chipiki/gnu_friata/README

FRIATA - Free/Open Telephone ATA Hardware
=========================================
Egg & Sausage Filled Tart and Hashbrowns

mailto:kalyanamsaritha_at_gmail_dot_com['Saritha Kalyanam']

+ 10/100 Mbps Ethernet interface
+ Single Port FXS - Analog telephone interface
+ USB Host (full speed) - Wifi USB dongle for wifi interface
+ USB Device (full speed) - USB phone device (a la Skype)

Directories
===========
sym/    Schematic symbol library. Borrowed heavily from
        http://www.gedasymbols.org

pkg/    Footprint library. Borrowed heavily from http://www.gedasymbols.org
