chipiki/gnu_friata/friata-bom.ods

Device | Value | Footprint | Manufacturer | Manufacturer Part | Vendor | Vendor Part | Quantity | Refdes
AT45DB161D | unknown | TSOP-28 |  |  |  |  | 1 | U15
AT91SAM9260 | unknown | PQFP-208 |  |  |  |  | 1 | U1
CAPACITOR | 100nF/25V | 603 |  |  |  |  | 57 | C1 C10 C101 C102 C11 C12 C16 C17 C18 C19 C2 C20 C21 C22 C23 C25 C3 C35 C36 C37 C38 C39 C4 C41 C42 C43 C44 C45 C46 C5 C52 C53 C54 C58 C6 C66 C67 C68 C69 C7 C70 C71 C72 C75 C78 C8 C88 C89 C9 C90 C91 C92 C93 C94 C95 C96 C97
CAPACITOR | 100nF/50V | 1206 |  |  |  |  | 1 | C55
CAPACITOR | 100uF/35V | PANASONIC_V_FC_10x10 |  |  |  |  | 3 | C74 C86 C87
CAPACITOR | 10nF/16V | 603 |  |  |  |  | 1 | C27
CAPACITOR | 10nF/50V | 805 |  |  |  |  | 1 | C100
CAPACITOR | 10uF/100V | PANASONIC_V_HA_8x10 |  |  |  |  | 1 | C56
CAPACITOR | 10uF/35V | PANASONIC_V_FC_5x5 |  |  |  |  | 1 | C65
CAPACITOR | 10uF/6.3V | 805 |  |  |  |  | 12 | C103 C104 C13 C14 C15 C24 C26 C40 C61 C62 C63 C64
CAPACITOR | 18pF | 603 |  |  |  |  | 6 | C29 C30 C31 C32 C33 C34
CAPACITOR | 1nF/25V | 603 |  |  |  |  | 4 | C28 C77 C98 C99
CAPACITOR | 1uF/25V | 805 |  |  |  |  | 4 | C80 C81 C83 C84
CAPACITOR | 220nF/100V | 805 |  |  |  |  | 2 | C50 C51
CAPACITOR | 22nF/100V | 805 |  |  |  |  | 2 | C59 C60
CAPACITOR | 4.7nF/25V | 805 |  |  |  |  | 2 | C76 C79
CAPACITOR | 4.7uF/16V | 805 |  |  |  |  | 2 | C47 C48
CAPACITOR | 4.7uF/25V | 805 |  |  |  |  | 1 | C73
CAPACITOR | 68uF/10V | 2512 |  |  |  |  | 2 | C82 C85
CONNECTOR-DB9-FEMALE | 190-009-263R001 | CONN-DB9-FEMALE-SMT |  |  |  |  | 1 | CONN4
CONNECTOR-DCJACK | RASM722P | CONN-RASM722-SMT |  |  |  |  | 1 | CONN3
CONNECTOR-RJ11 | MOLEX-44144-0005 | CONN-RJ11-6P6C-SMT |  |  |  |  | 1 | CONN7
CONNECTOR-RJ45 | J3026G01DNL | CONN-RJ45-J3026G01DNL |  |  |  |  | 1 | CONN1
CONNECTOR-USB-A-FEMALE | KUSBX-SMT-AS1N-xxx | CONN-USB-A-FEMALE-SMT |  |  |  |  | 1 | CONN5
CONNECTOR-USB-B-FEMALE | KUSBX-SMT-BS1N-xxx | CONN-USB-B-FEMALE-SMT |  |  |  |  | 1 | CONN6
CRYSTAL | 18.432 MHz | XTAL-CITIZEN-HCM49 |  |  |  |  | 1 | X1
CRYSTAL | 25MHz | XTAL-CITIZEN-HCM49 |  |  |  |  | 1 | X3
CRYSTAL | 32.768 kHz | XTAL-ECS-ECX39 |  |  |  |  | 1 | X2
DIODE | ES1D | DO-214 |  |  |  |  | 1 | D1
DIODE-BRIDGE | DF10s | SDIP-4L |  |  |  |  | 1 | U20
DM83848I | unknown | PQFP-48 |  |  |  |  | 1 | U13
FUSE | 500mA | 2920 |  |  |  |  | 2 | F1 F2
HEADER | unknown | HEADER-0.1in_20pin_2row-THRU |  |  |  |  | 1 | J4
HEADER | unknown | HEADER-0.1in_2pin_1row-THRU |  |  |  |  | 6 | J1 J10 J2 J3 J5 J7
HEADER | unknown | HEADER-0.1in_3pin_1row-THRU |  |  |  |  | 2 | J8 J9
HOLE | unknown | HOLE_M3 |  |  |  |  | 4 | H1 H2 H3 H4
INDUCTOR | 100uH/1.5A | MURATA_4500 |  |  |  |  | 1 | L5
INDUCTOR | 100uH/1.5A | MURATA_4600 |  |  |  |  | 1 | L8
INDUCTOR | 22uH/1.5A | MURATA_4600 |  |  |  |  | 2 | L6 L7
INDUCTOR | 4.7uH/150mA | 603 |  |  |  |  | 2 | L1 L9
INDUCTOR | 47uH/150mA | 603 |  |  |  |  | 1 | L2
INDUCTOR | BLM18AG601SN1 | 603 |  |  |  |  | 2 | L3 L4
LED | unknown | 1206 |  |  |  |  | 3 | D2 D6 D7
LM2675 | unknown | SO-8 |  |  |  |  | 1 | U25
LM2717 | unknown | TSSOP-24 |  |  |  |  | 1 | U19
MT29F2G08AACWP-ET | unknown | TSOP-48 |  |  |  |  | 1 | U14
MT48LC8M16A2P-75-L | unknown | TSOP-54 |  |  |  |  | 1 | U18
RESISTOR | 0 | 603 |  |  |  |  | 18 | R37 R38 R60 R61 R62 R63 R64 R65 R66 R67 R68 R69 R86 R87 R88 R89 R90 R91
RESISTOR | 0.68 | 805 |  |  |  |  | 1 | R33
RESISTOR | 1.5K | 603 |  |  |  |  | 1 | R85
RESISTOR | 1.5M | 603 |  |  |  |  | 1 | R3
RESISTOR | 100K | 603 |  |  |  |  | 10 | R1 R4 R42 R43 R44 R45 R52 R53 R54 R55
RESISTOR | 10K | 603 |  |  |  |  | 3 | R41 R47 R5
RESISTOR | 15 | 805 |  |  |  |  | 1 | R24
RESISTOR | 15K | 603 |  |  |  |  | 1 | R58
RESISTOR | 196K | 603 |  |  |  |  | 2 | R19 R20
RESISTOR | 1K | 603 |  |  |  |  | 4 | R16 R2 R6 R7
RESISTOR | 2.2K | 603 |  |  |  |  | 2 | R13 R14
RESISTOR | 200 | 603 |  |  |  |  | 2 | R32 R34
RESISTOR | 200K | 603 |  |  |  |  | 3 | R26 R28 R39
RESISTOR | 20K | 603 |  |  |  |  | 2 | R46 R48
RESISTOR | 220 | 603 |  |  |  |  | 4 | R15 R51 R56 R57
RESISTOR | 22K | 603 |  |  |  |  | 2 | R49 R59
RESISTOR | 243 | 603 |  |  |  |  | 1 | R35
RESISTOR | 26.1K | 603 |  |  |  |  | 1 | R23
RESISTOR | 33 | 603 |  |  |  |  | 15 | R70 R71 R72 R73 R74 R75 R76 R77 R78 R79 R80 R81 R82 R83 R84
RESISTOR | 4.02K | 603 |  |  |  |  | 2 | R21 R22
RESISTOR | 4.87K | 603 |  |  |  |  | 1 | R12
RESISTOR | 40.2K | 603 |  |  |  |  | 2 | R36 R40
RESISTOR | 470 | 603 |  |  |  |  | 2 | R27 R29
RESISTOR | 470K | 603 |  |  |  |  | 2 | R17 R18
RESISTOR | 49.9 | 603 |  |  |  |  | 4 | R10 R11 R8 R9
RESISTOR | 51K | 603 |  |  |  |  | 1 | R50
RESISTOR | 56.2K | 603 |  |  |  |  | 2 | R30 R31
RESISTOR | 665K | 603 |  |  |  |  | 1 | R25
SCHOTTKY-DIODE | MBRS130LT3G | 403-03 |  |  |  |  | 1 | D5
SCHOTTKY-DIODE | MBRS340T3G | 403-03 |  |  |  |  | 2 | D3 D4
Si3201 | unknown | SOIC-16 |  |  |  |  | 1 | U16
Si3215 | unknown | TSSOP-38 |  |  |  |  | 1 | U17
SIDACTOR | P3100SB | DO-214AA |  |  |  |  | 1 | RV1
ST3232 | unknown | TSSOP-16 |  |  |  |  | 1 | U22
SWITCH-PUSHBUTTON-NO | unknown | SWITCH-SKHMQ |  |  |  |  | 3 | S1 S2 S3
TESTPOINT | unknown | PAD-ROUND-SMT |  |  |  |  | 8 | TP1 TP2 TP3 TP4 TP5 TP6 TP7 TP8
TRANSFORMER | DLW5BSN102SQ2 | 2020 |  |  |  |  | 1 | T1
TRANSISTOR | 2N2222 | SOT-23 |  |  |  |  | 2 | Q2 Q3
TRANSISTOR | FZT953 | SOT-223 |  |  |  |  | 1 | Q1
USBDF01W5 | unknown | SOT-323-5L |  |  |  |  | 1 | U23
USBUF01W6 | unknown | SOT-323-6L |  |  |  |  | 1 | U24
