chipiki/gnu_friata/doc/parts/parts.txt

References
==========

http://focus.ti.com/lit/ug/sleu002/sleu002.pdf
