chipiki/gnu_friata/doc/debug/debug.txt

Oscilloscopes

http://www.pctestinstruments.com/
