chipiki/gnu_friata/friata.pdf

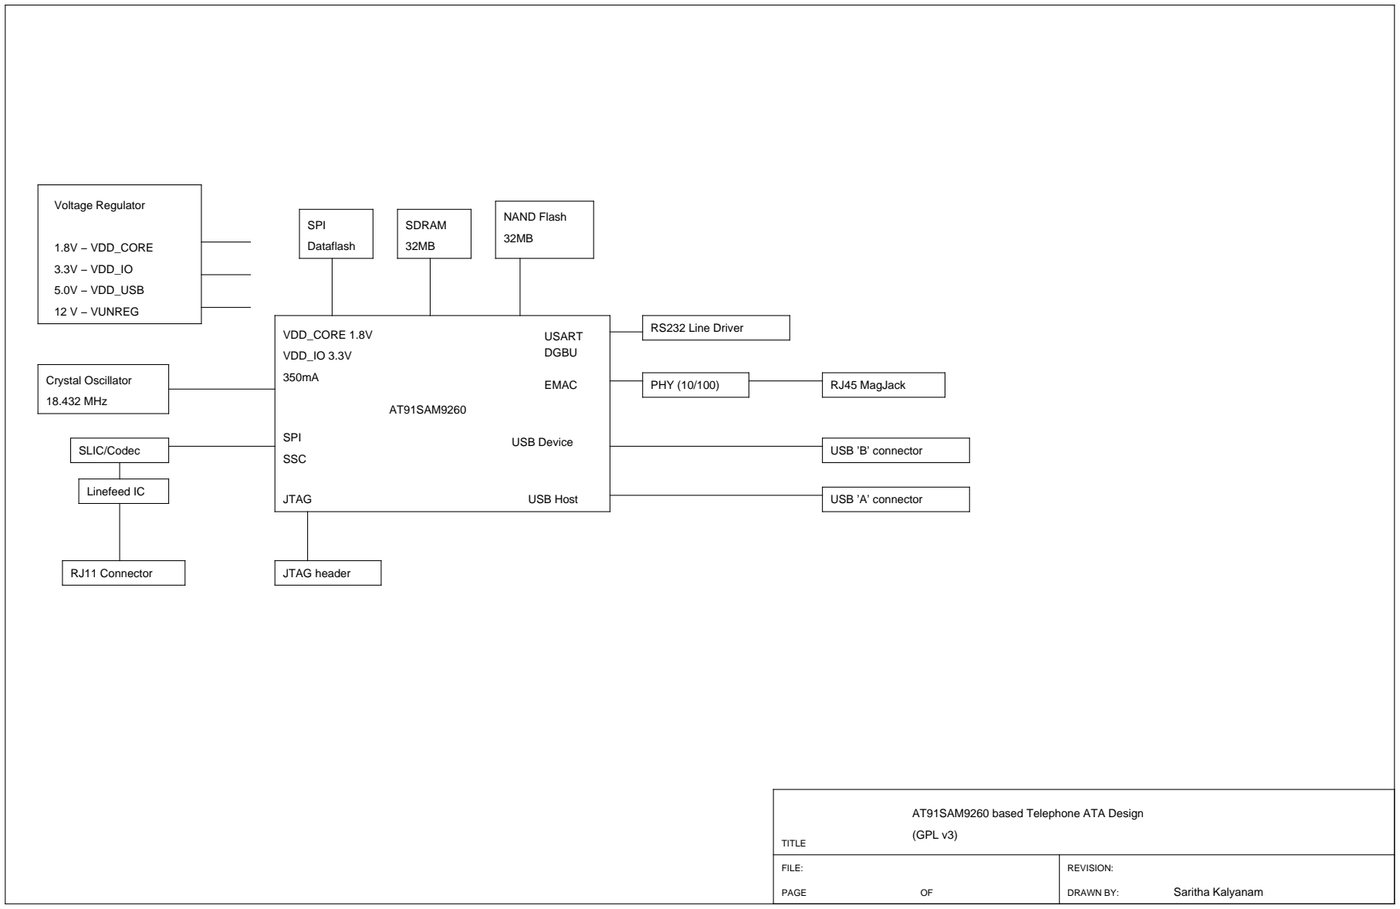
[picture p1: figure]
FILE:; REVISION:; PAGE; DRAWN BY:; TITLE; Voltage Regulator; 1.8V − VDD_CORE; 3.3V − VDD_IO; 5.0V − VDD_USB; 12 V − VUNREG; AT91SAM9260; VDD_CORE 1.8V; VDD_IO 3.3V; USART; JTAG; SPI; SSC; USB Host; USB Device; EMAC; RS232 Line Driver; PHY (10/100); RJ45 MagJack; USB ’A’ connector; USB ’B’ connector; JTAG header; Crystal Oscillator; 18.432 MHz; SLIC/Codec; Linefeed IC; RJ11 Connector; AT91SAM9260 based Telephone ATA Design; (GPL v3); Saritha Kalyanam; SDRAM; NAND Flash; DGBU; Dataflash
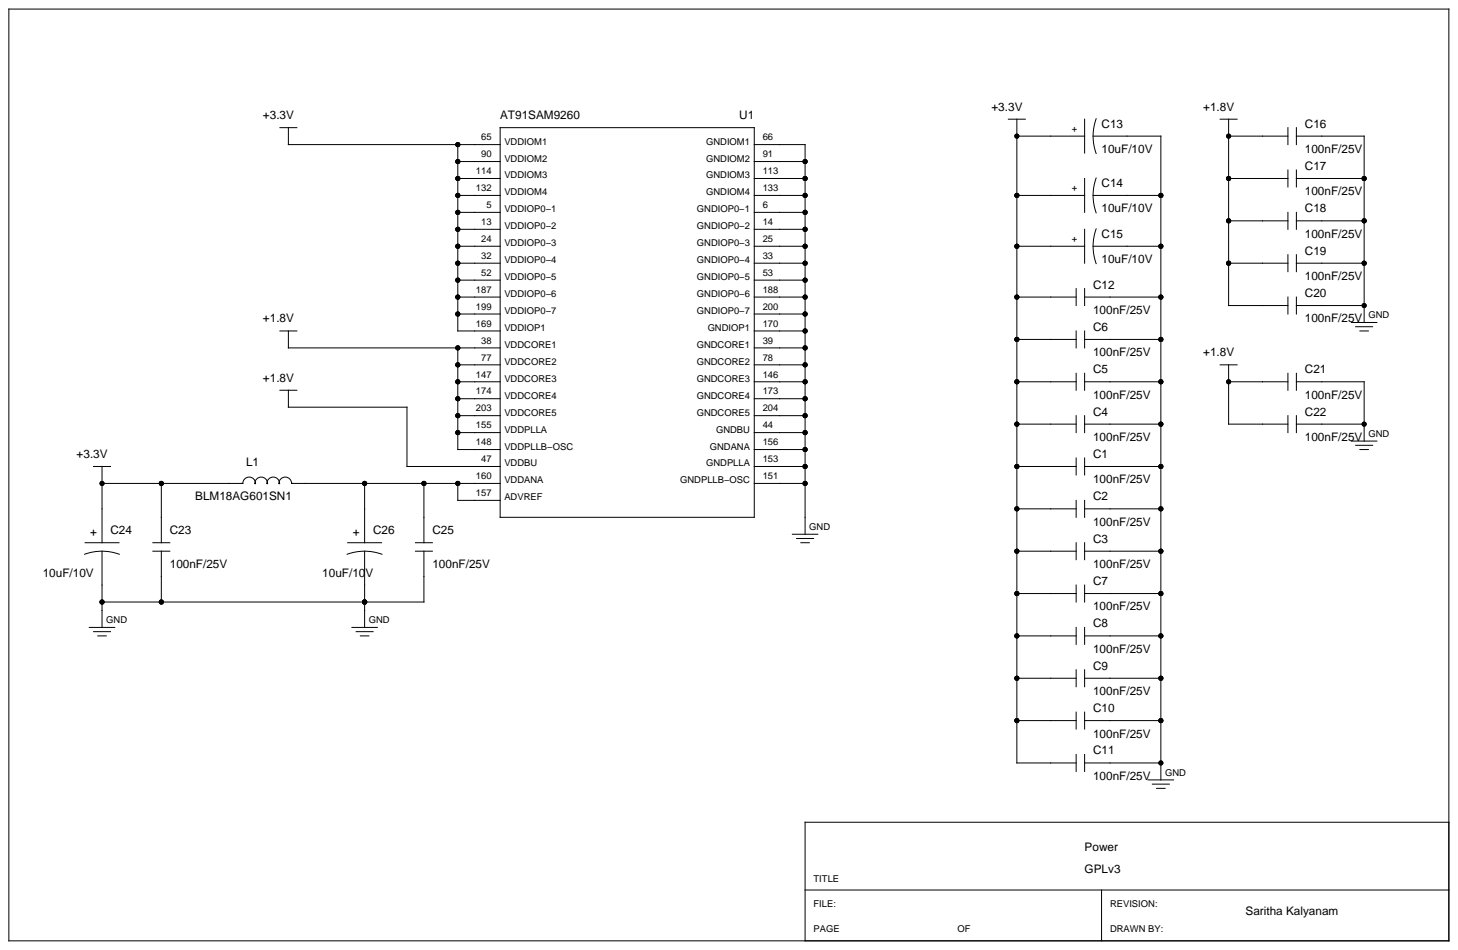
[picture p2: page 2]

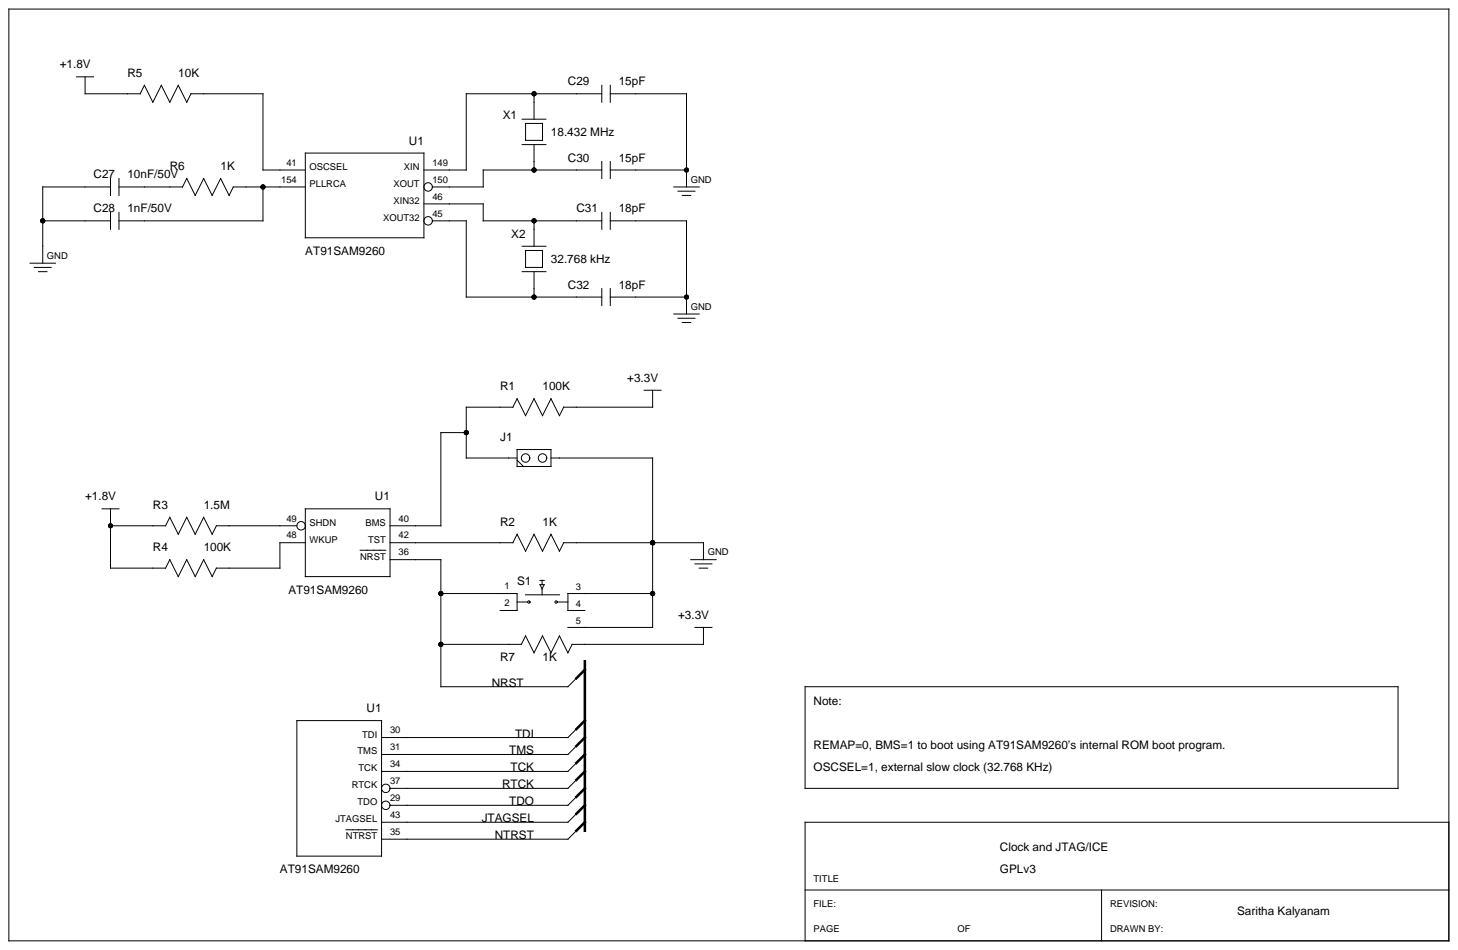
[picture p3: page 3]

REMAP=0, BMS=1 to boot using AT91SAM9260’s internal ROM boot program.
OSCSEL=1, external slow clock (32.768 KHz)

Clock and JTAG/ICE
GPLv3

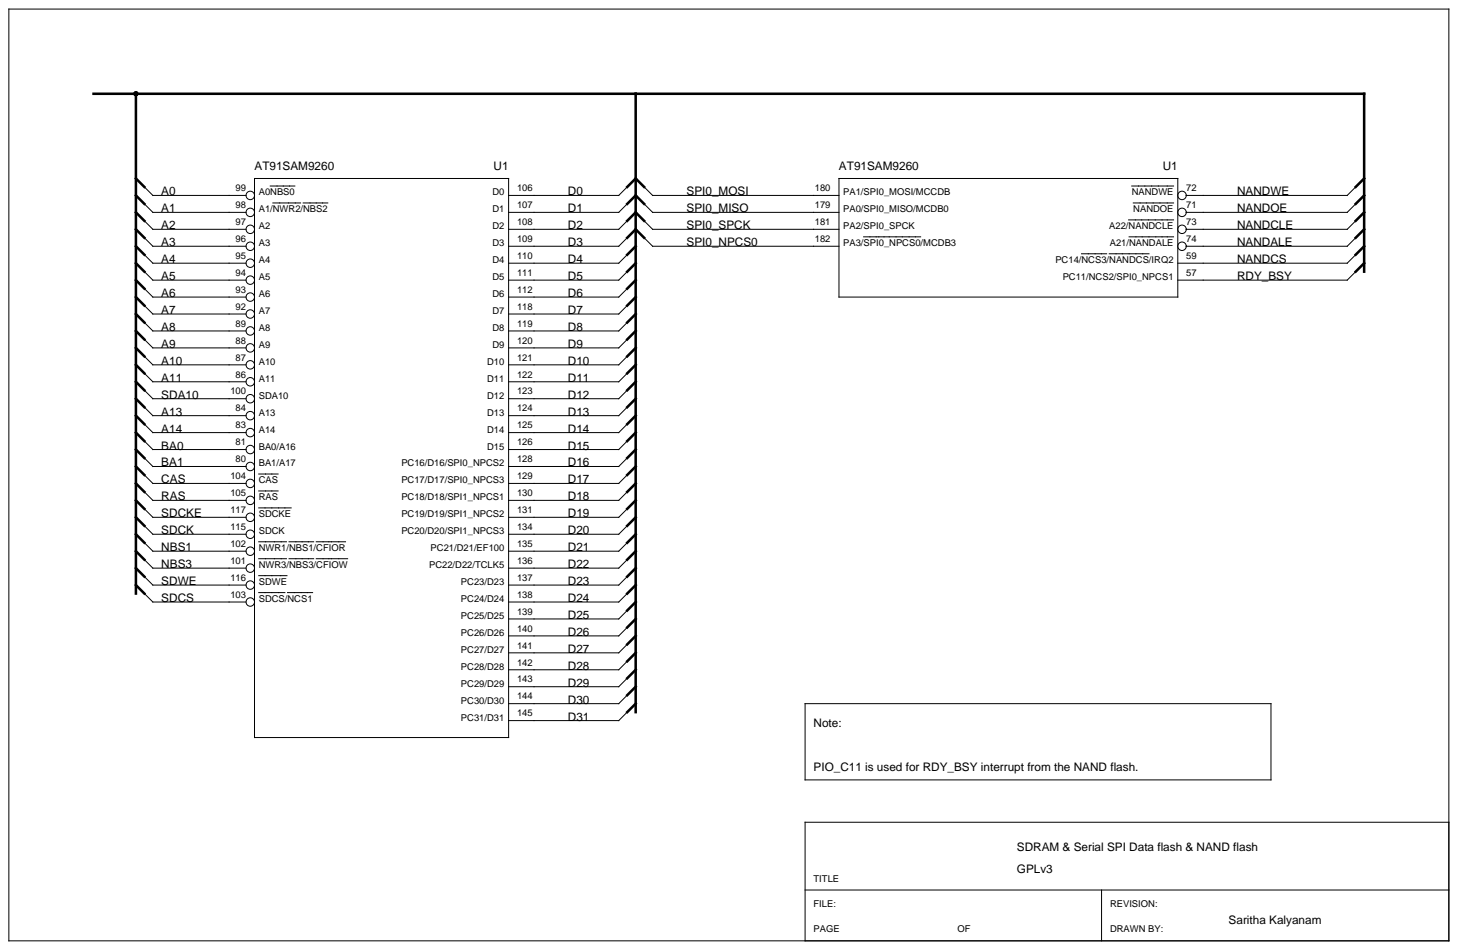
[picture p4: page 4]

PIO_C11 is used for RDY_BSY interrupt from the NAND flash.

SDRAM & Serial SPI Data flash & NAND flash
GPLv3

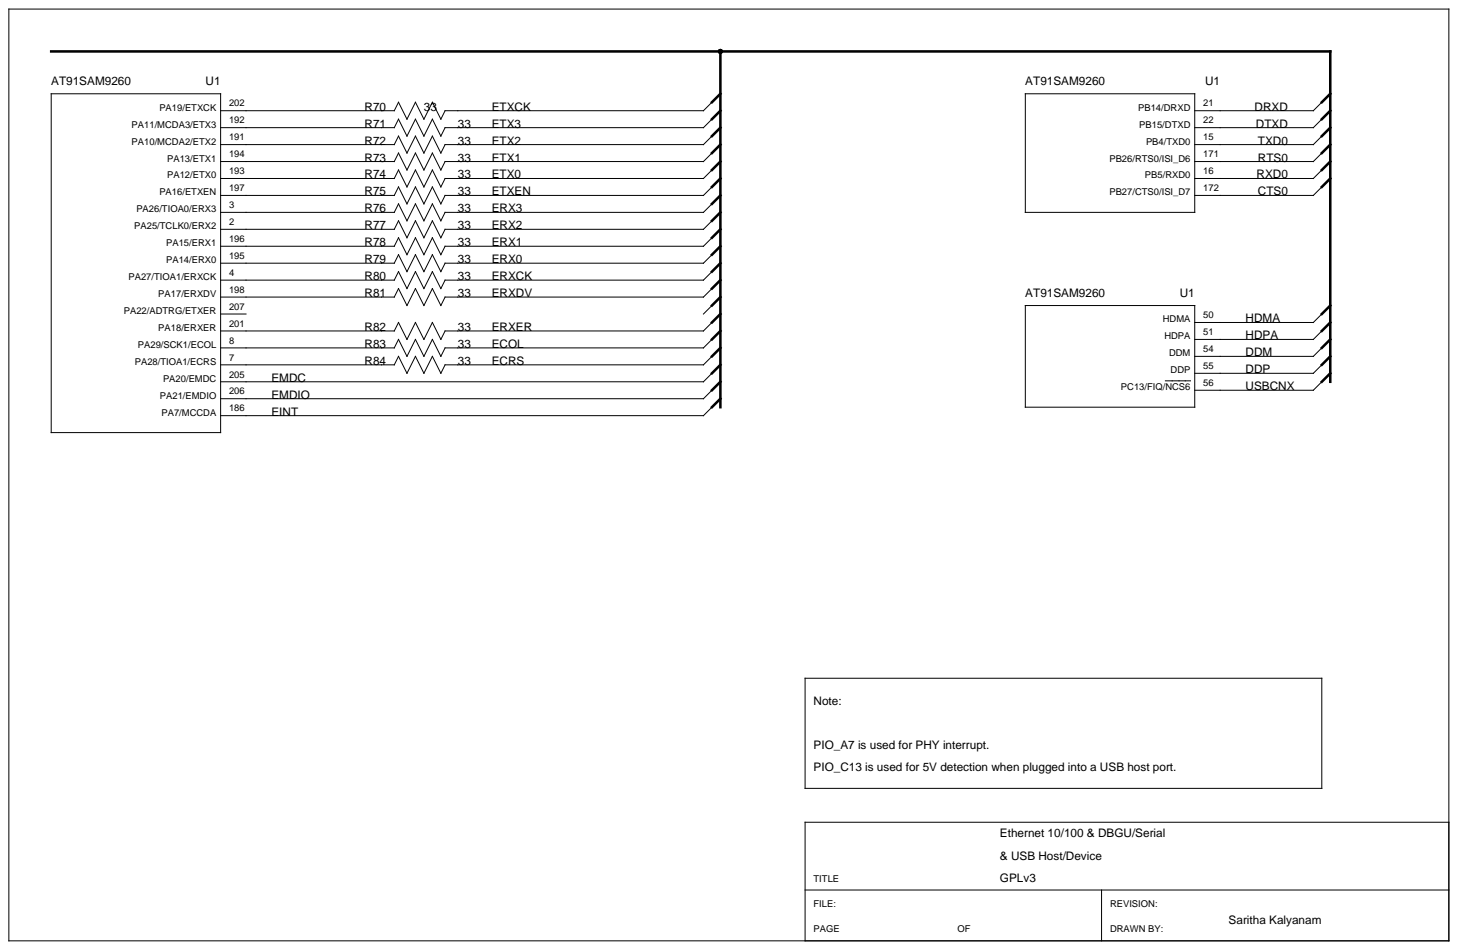
[picture p5: page 5]

PIO_A7 is used for PHY interrupt.
PIO_C13 is used for 5V detection when plugged into a USB host port.

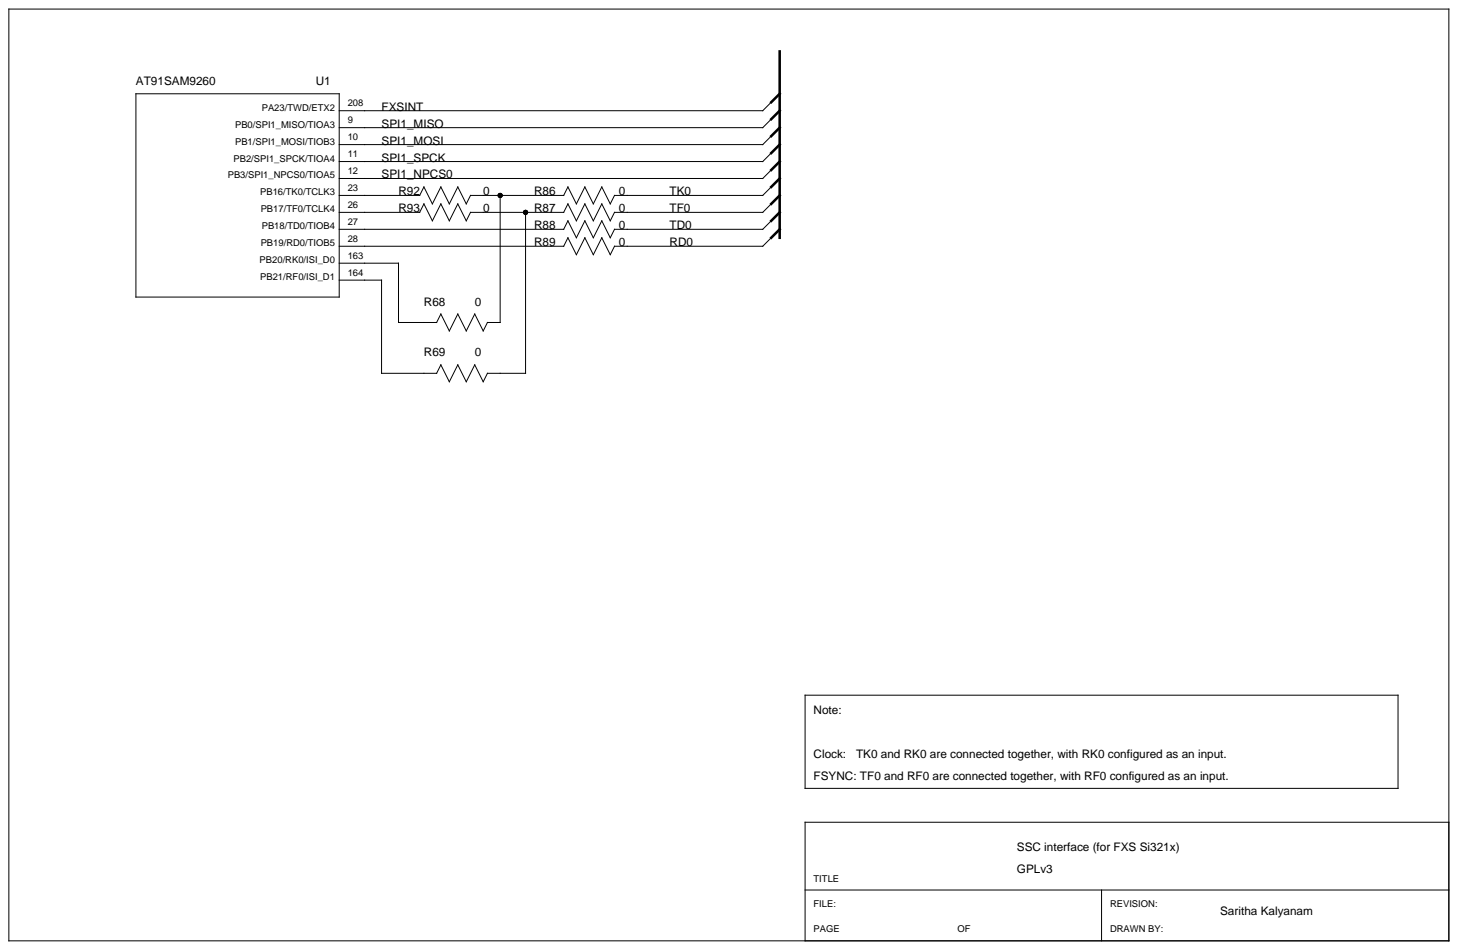
[picture p6: page 6]

Clock: TK0 and RK0 are connected together, with RK0 configured as an input.
FSYNC: TF0 and RF0 are connected together, with RF0 configured as an input.

SSC interface (for FXS Si321x)
GPLv3

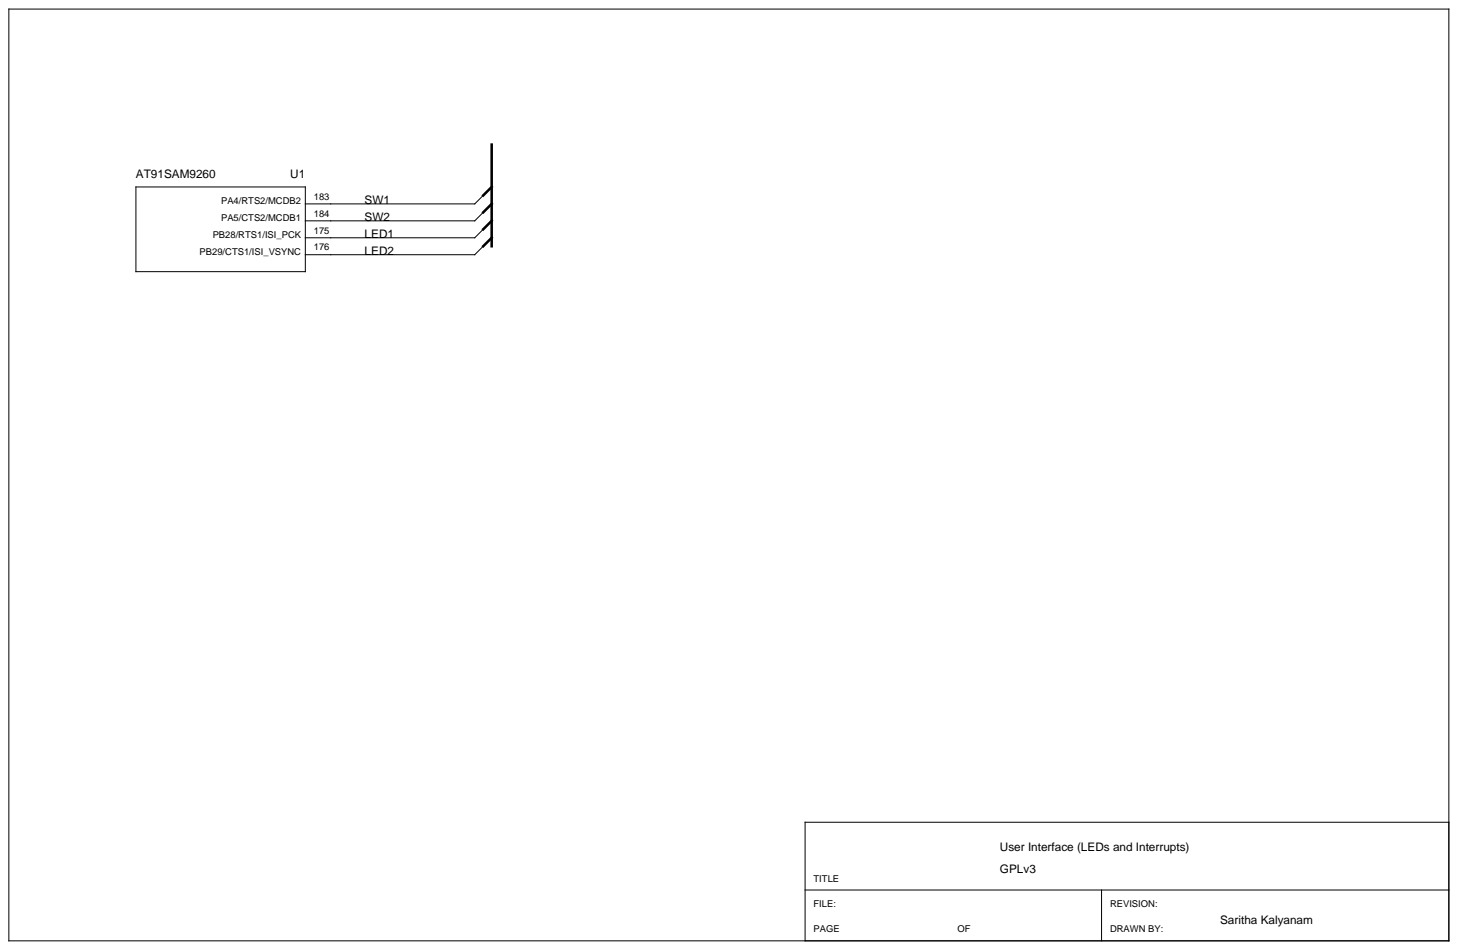
[picture p7: page 7]
FILE:; REVISION:; PAGE; DRAWN BY:; TITLE; 183 PA4/RTS2/MCDB2; 184 PA5/CTS2/MCDB1; 175 PB28/RTS1/ISI_PCK; 176 PB29/CTS1/ISI_VSYNC; AT91SAM9260; Saritha Kalyanam; SW1 SW2 LED1 LED2

User Interface (LEDs and Interrupts)
GPLv3

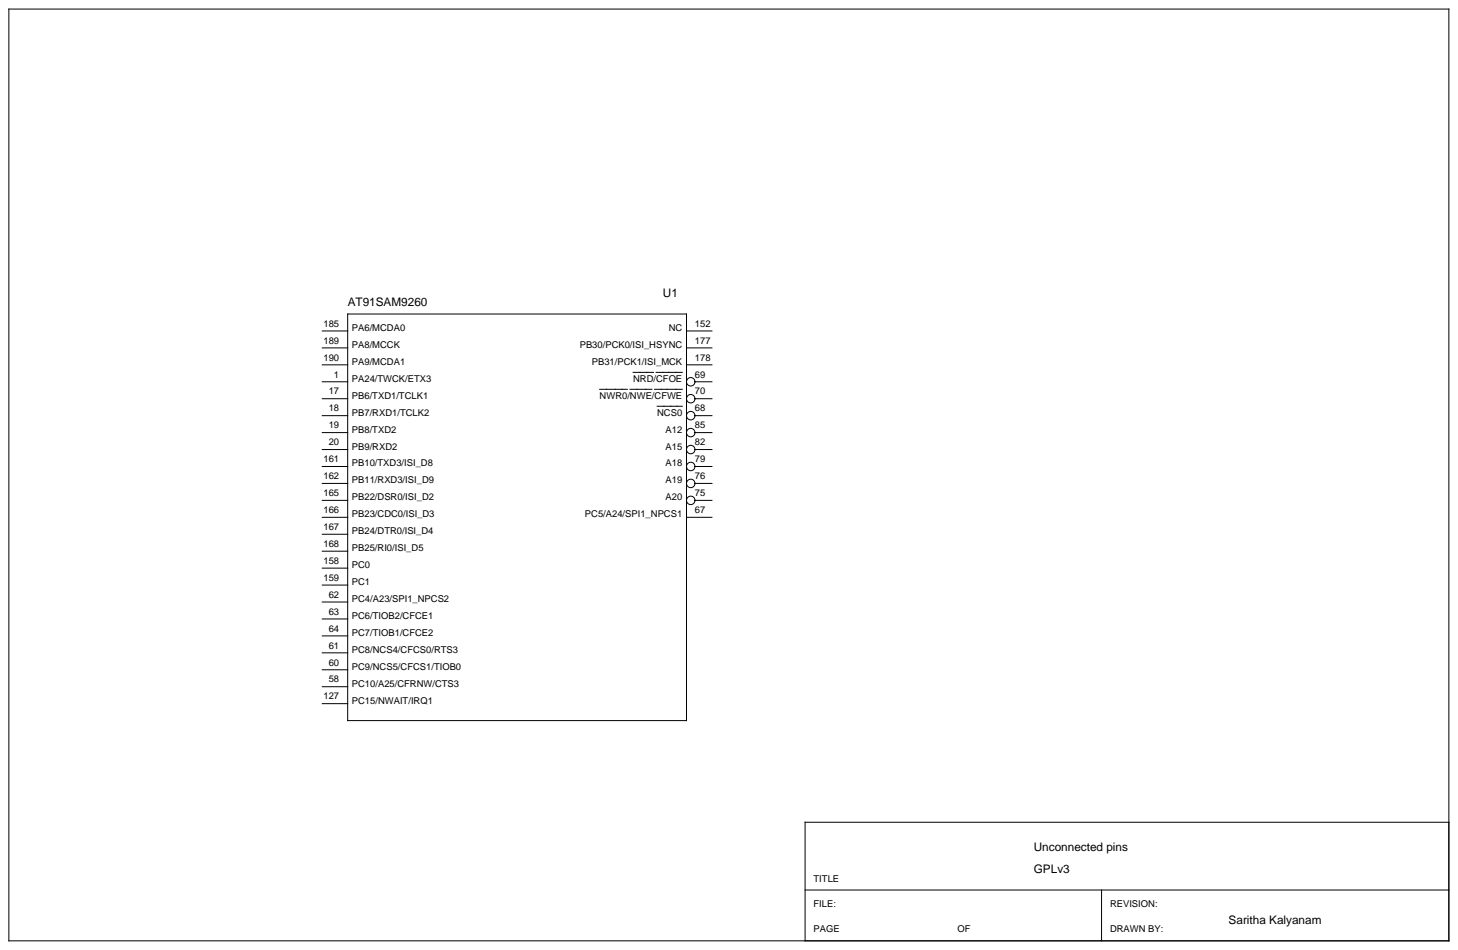
[picture p8: page 8]
FILE:; REVISION:; PAGE; DRAWN BY:; TITLE; Saritha Kalyanam; Unconnected pins; GPLv3; PA6/MCDA0; PA8/MCCK; PA9/MCDA1; PA24/TWCK/ETX3; PB6/TXD1/TCLK1; PB7/RXD1/TCLK2; PB8/TXD2; PB9/RXD2; PB10/TXD3/ISI_D8; PB11/RXD3/ISI_D9; PB22/DSR0/ISI_D2; PB23/CDC0/ISI_D3; PB24/DTR0/ISI_D4; PB25/RI0/ISI_D5; 177 PB30/PCK0/ISI_HSYNC; 178 PB31/PCK1/ISI_MCK; 69 NRD/CFOE; 70 NWR0/NWE/CFWE; 68 NCS0; 67 PC5/A24/SPI1_NPCS1; PC4/A23/SPI1_NPCS2; PC6/TIOB2/CFCE1; PC7/TIOB1/CFCE2; PC8/NCS4/CFCS0/RTS3; PC9/NCS5/CFCS1/TIOB0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

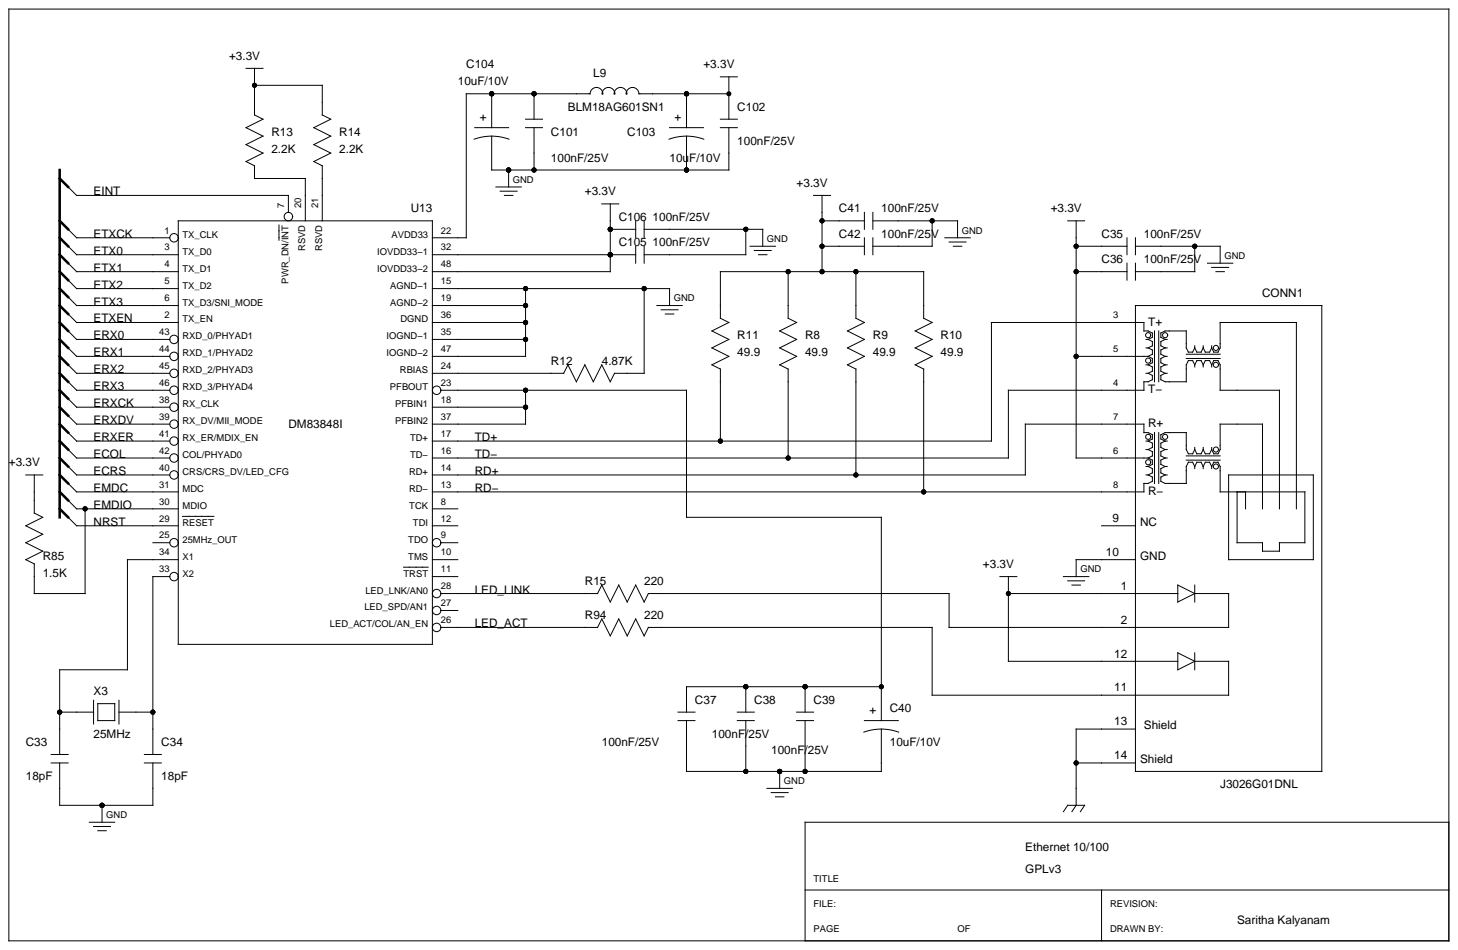
[picture p9: page 9]

16 TD− TD−
14 RD+ RD+
13 RD− RD−

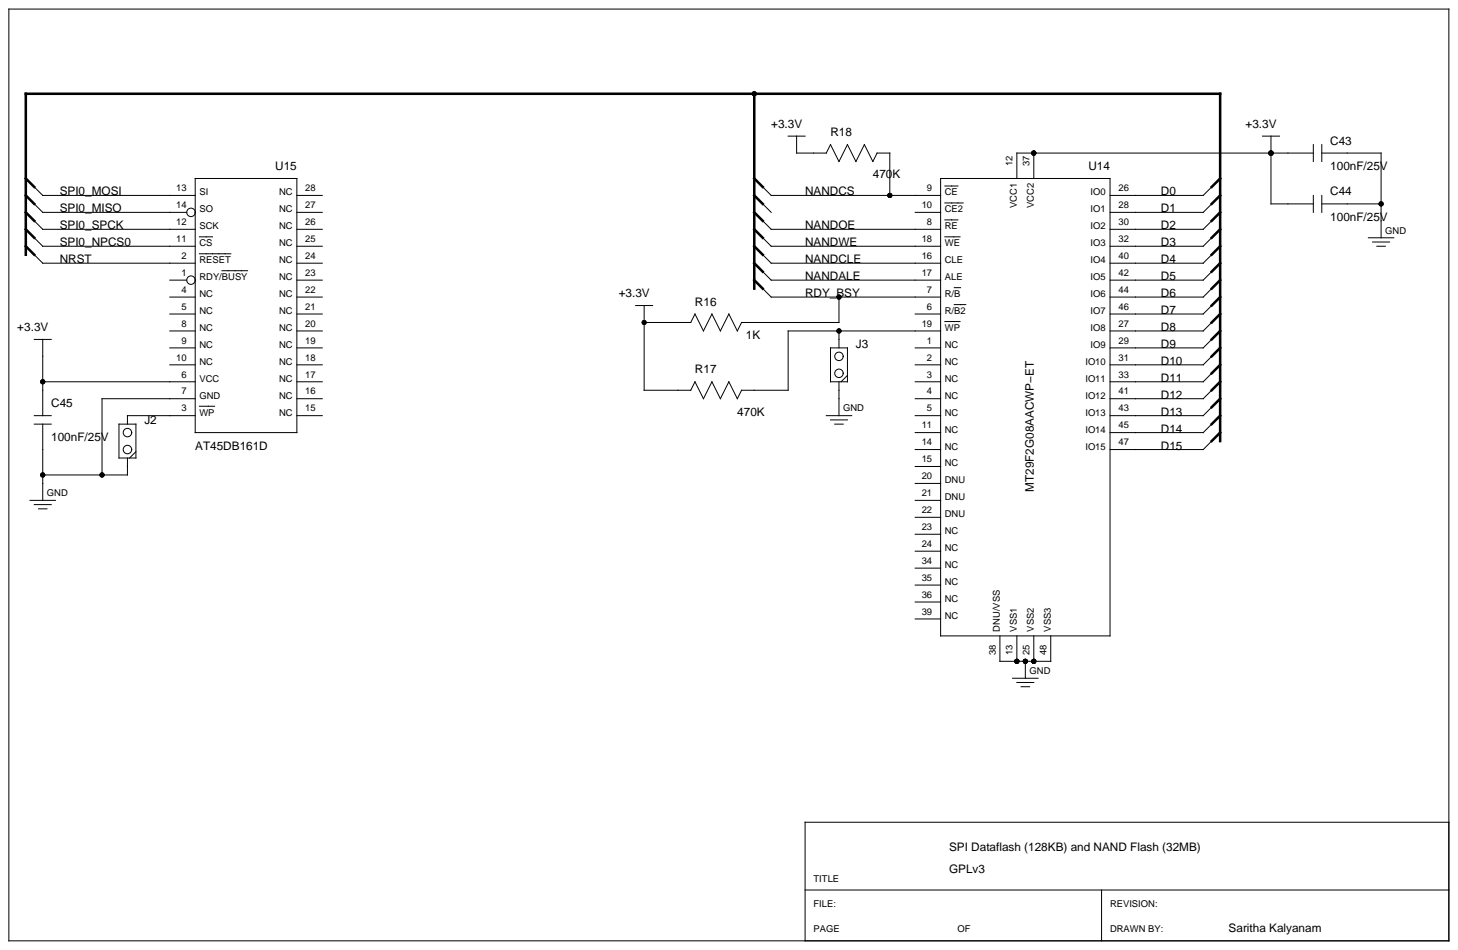
[picture p10: page 10]

SPI Dataflash (128KB) and NAND Flash (32MB)
GPLv3

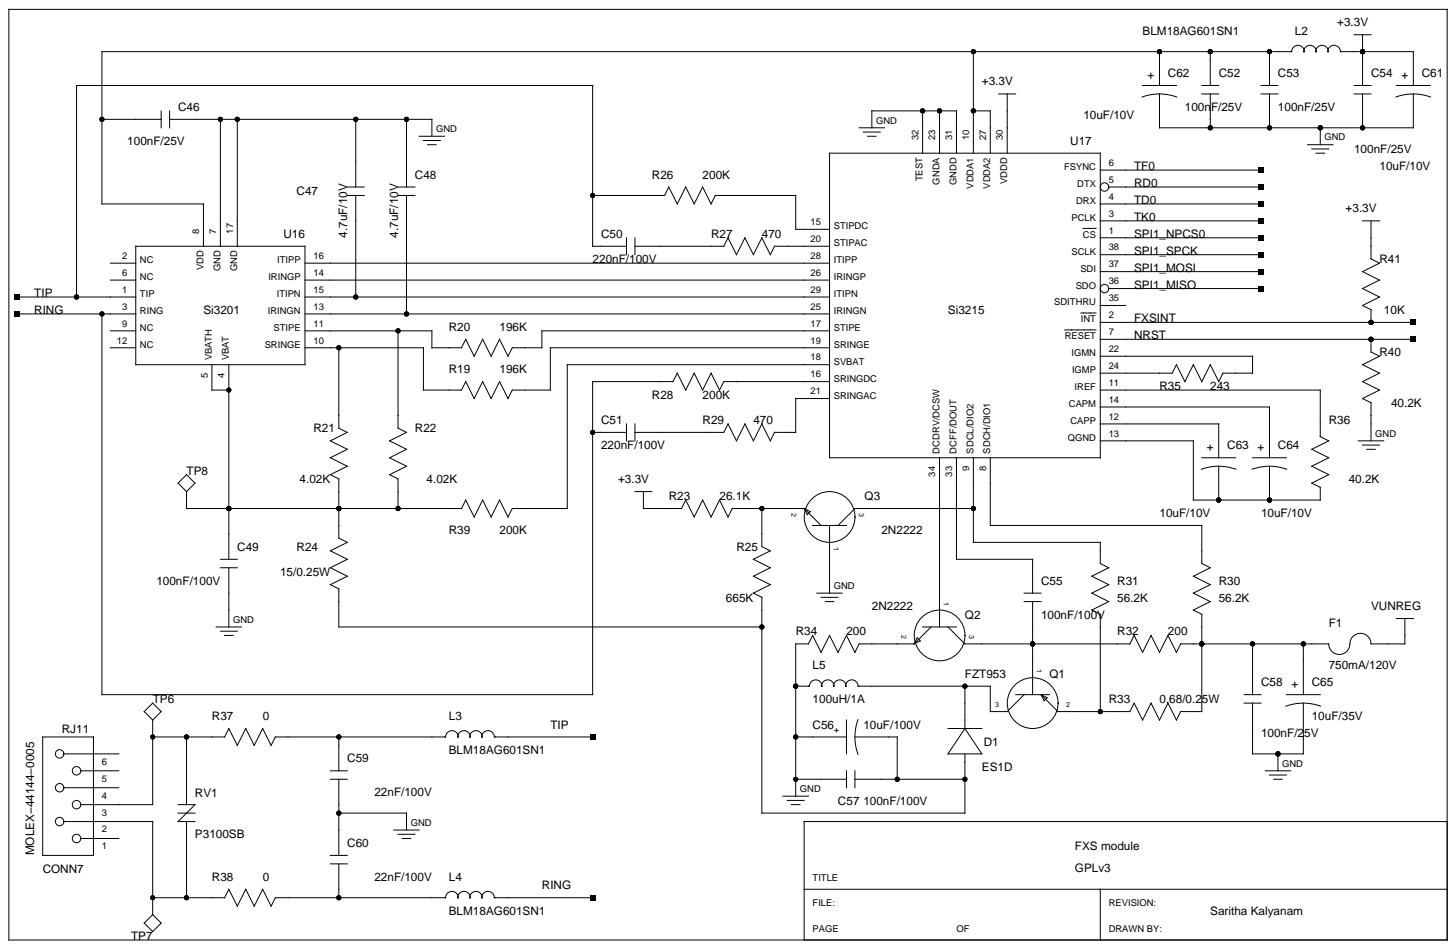
[picture p11: page 11]

33 DCFF/DOUT 9 SDCL/DIO2 8 SDCH/DIO1

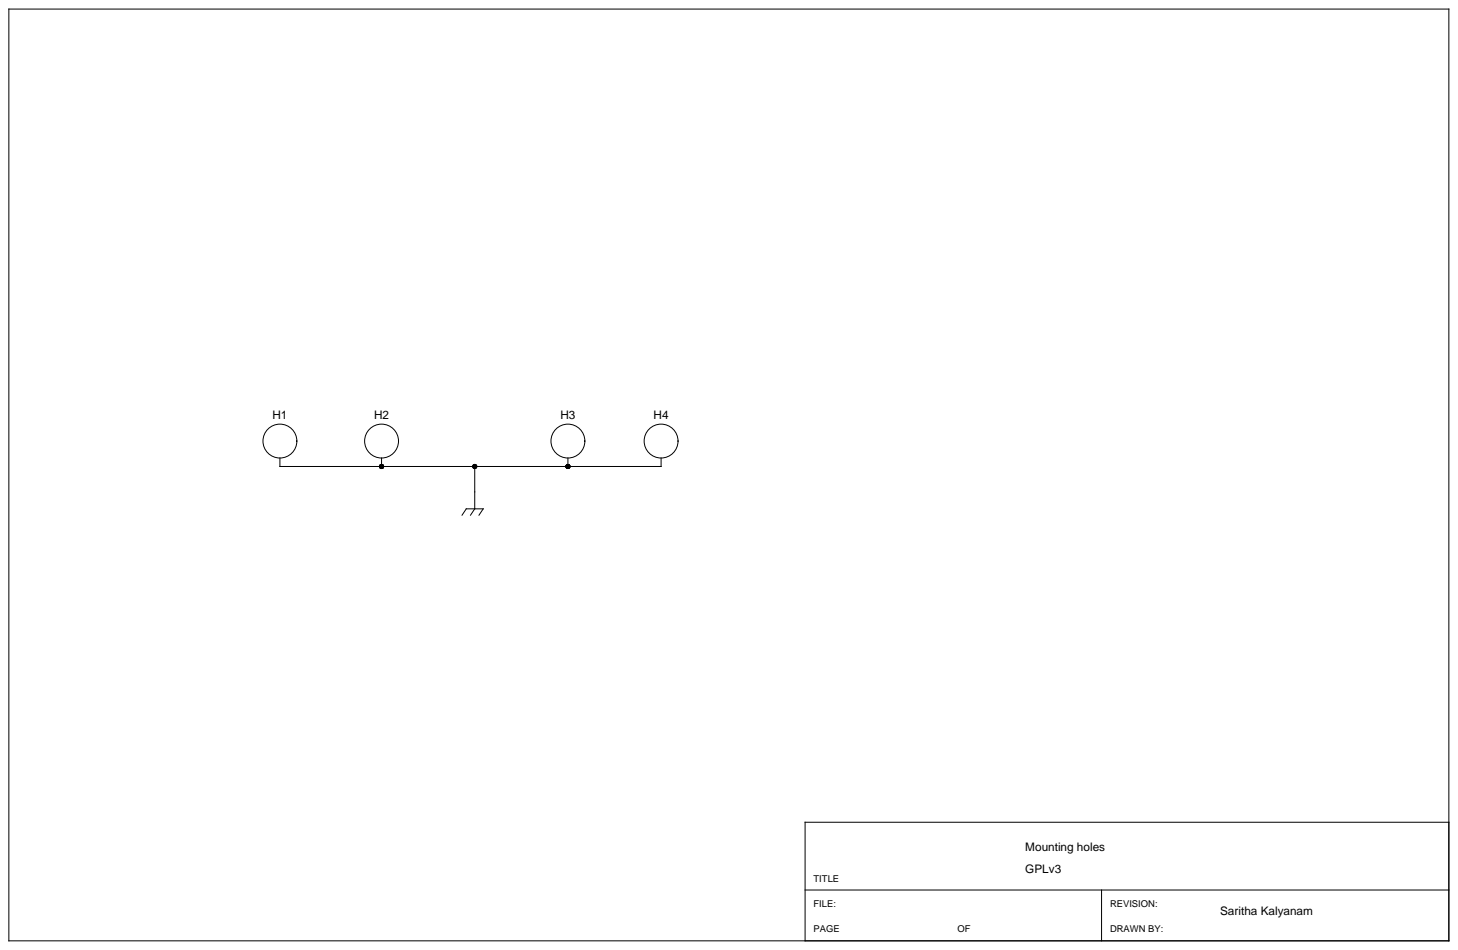
[picture p12: page 12]
FILE:; REVISION:; PAGE; DRAWN BY:; TITLE; Mounting holes; GPLv3; Saritha Kalyanam

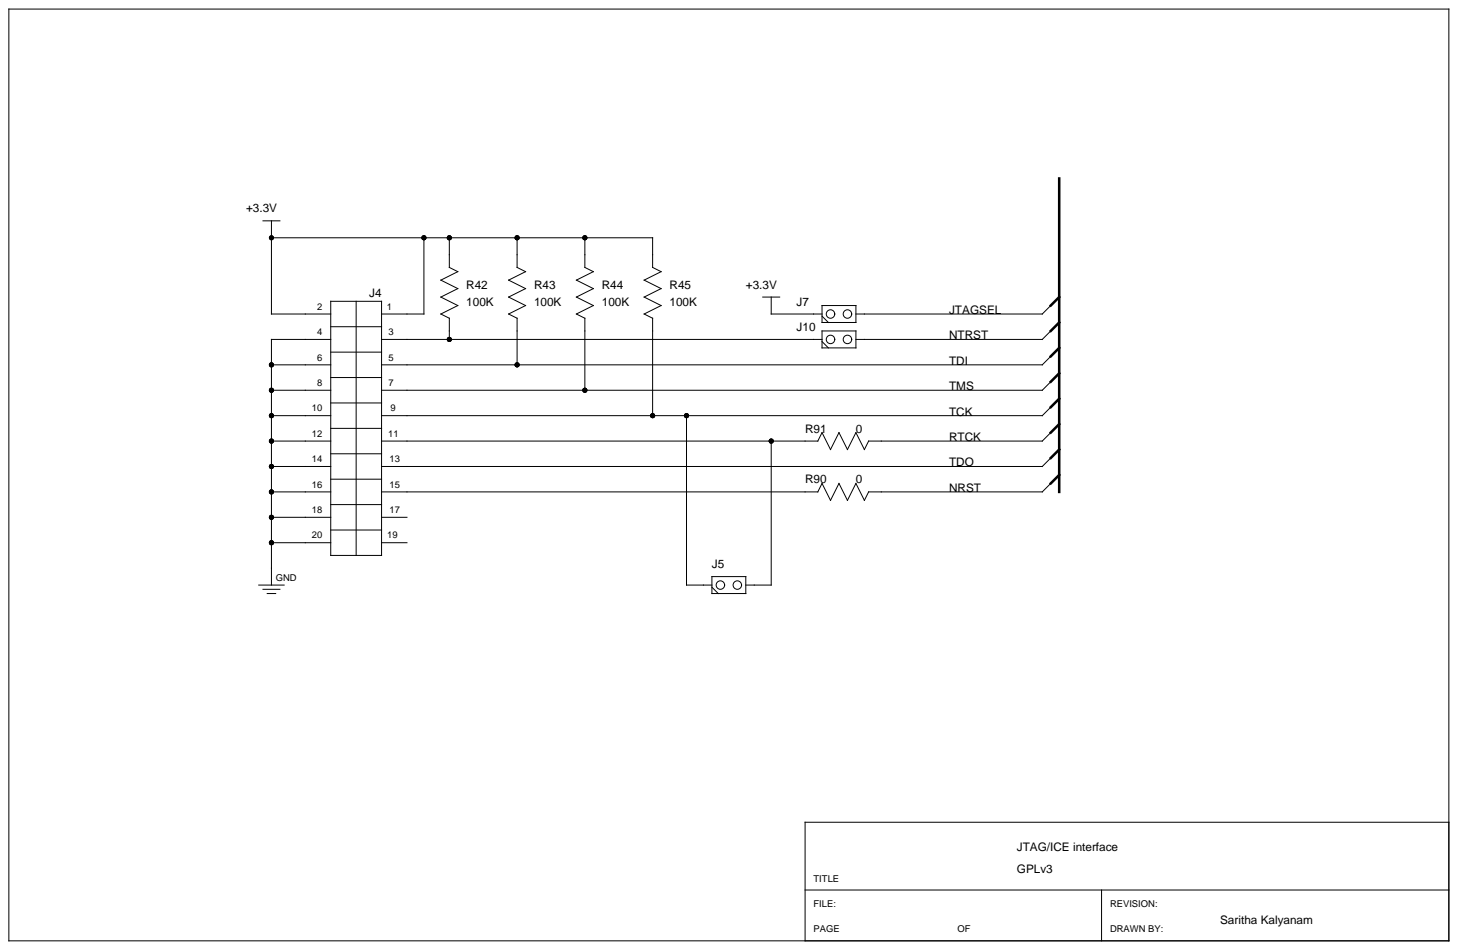
[picture p13: page 13]

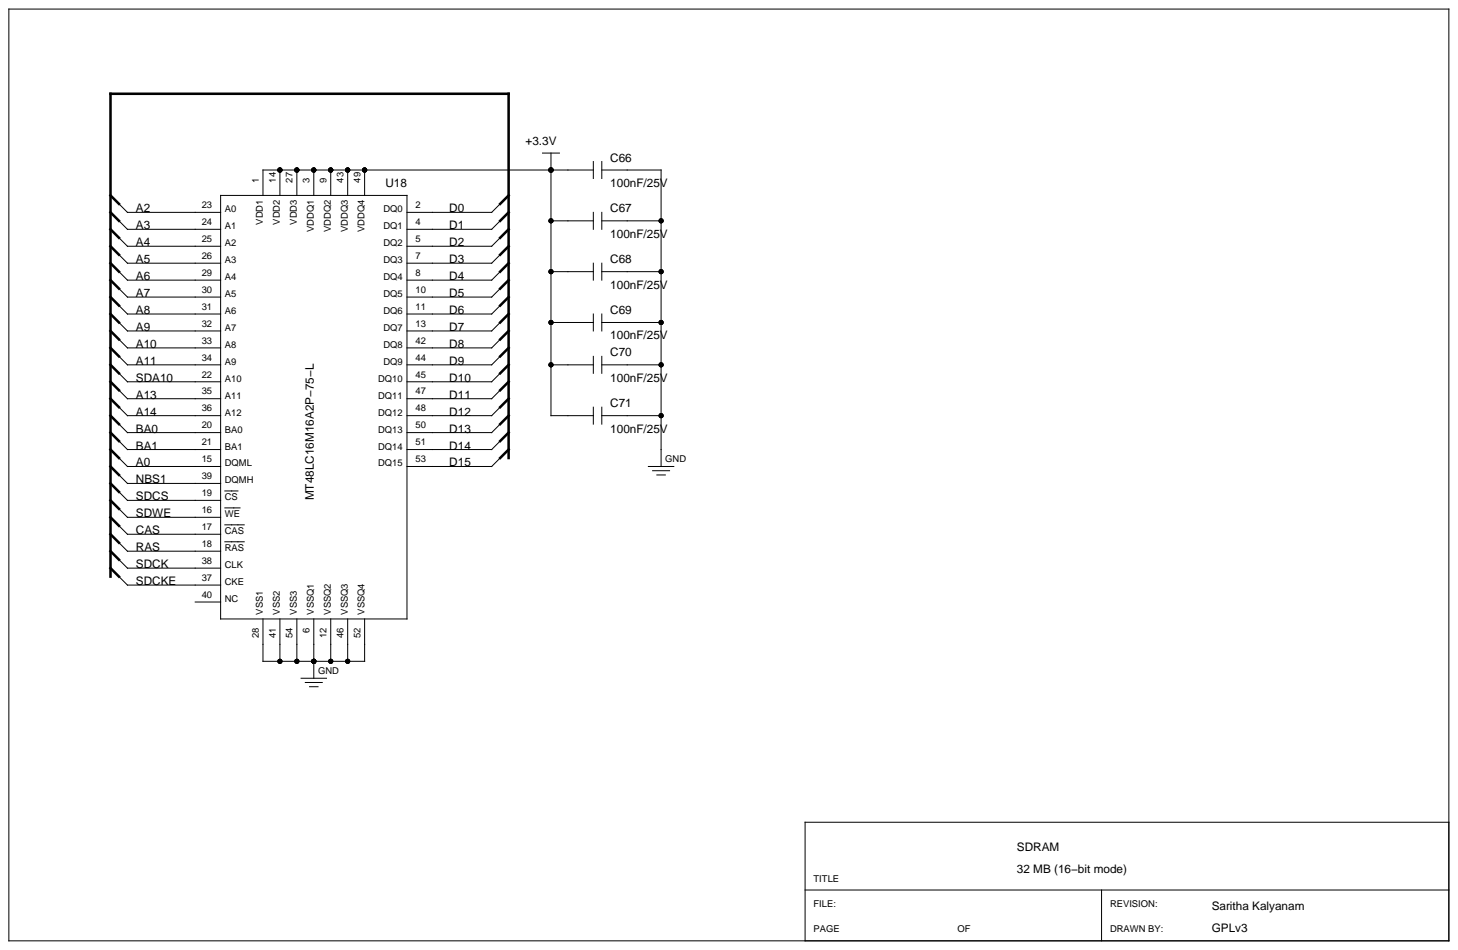
[picture p14: page 14]

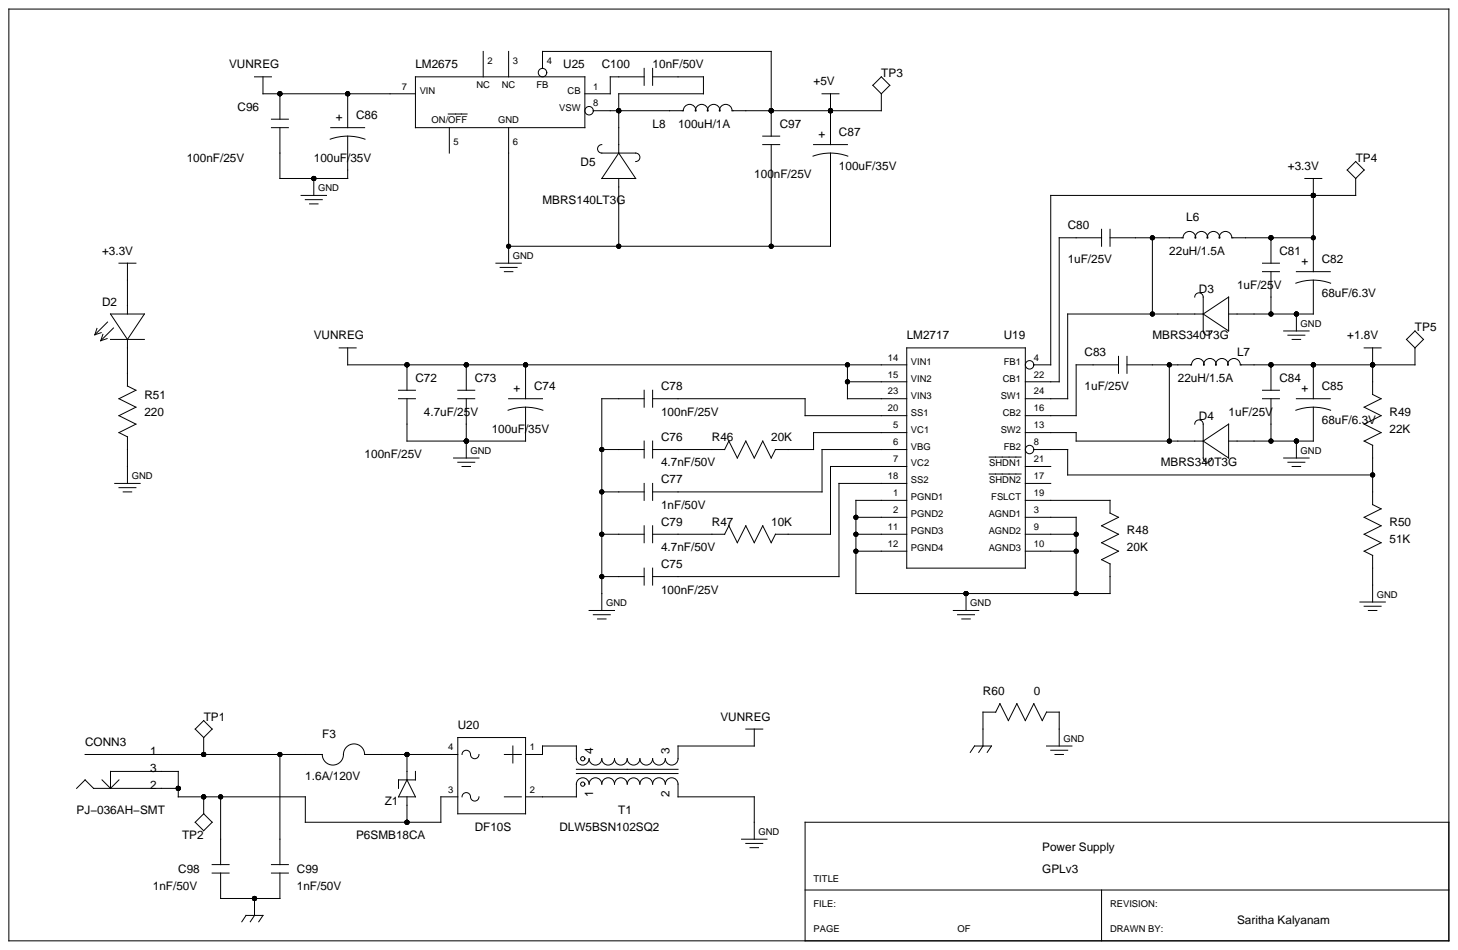
[picture p15: page 15]

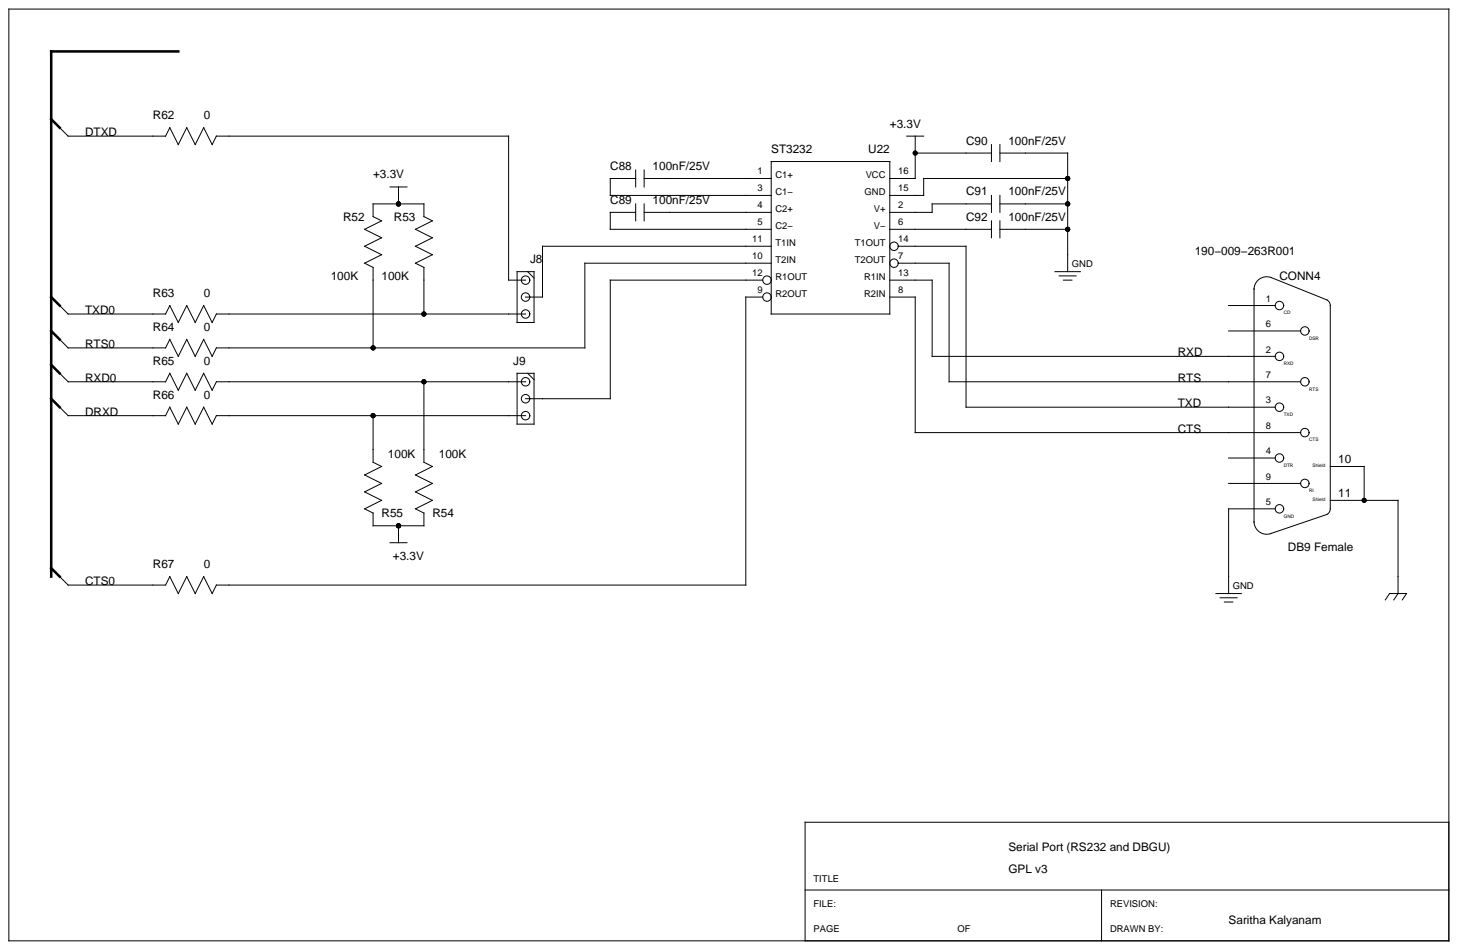
[picture p16: page 16]

Serial Port (RS232 and DBGU)
GPL v3

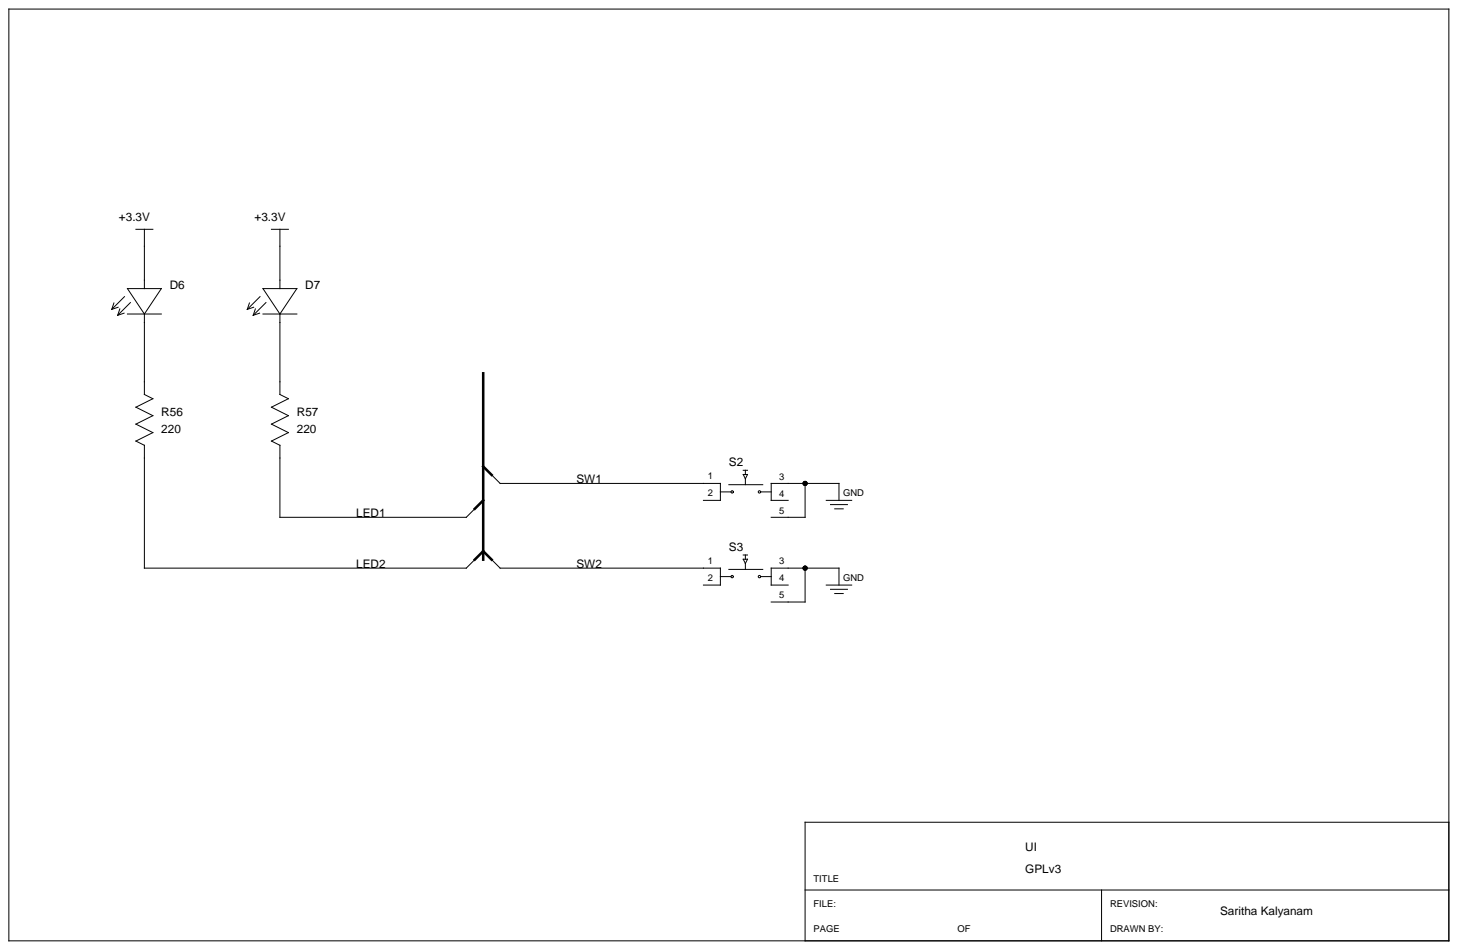
[picture p17: page 17]

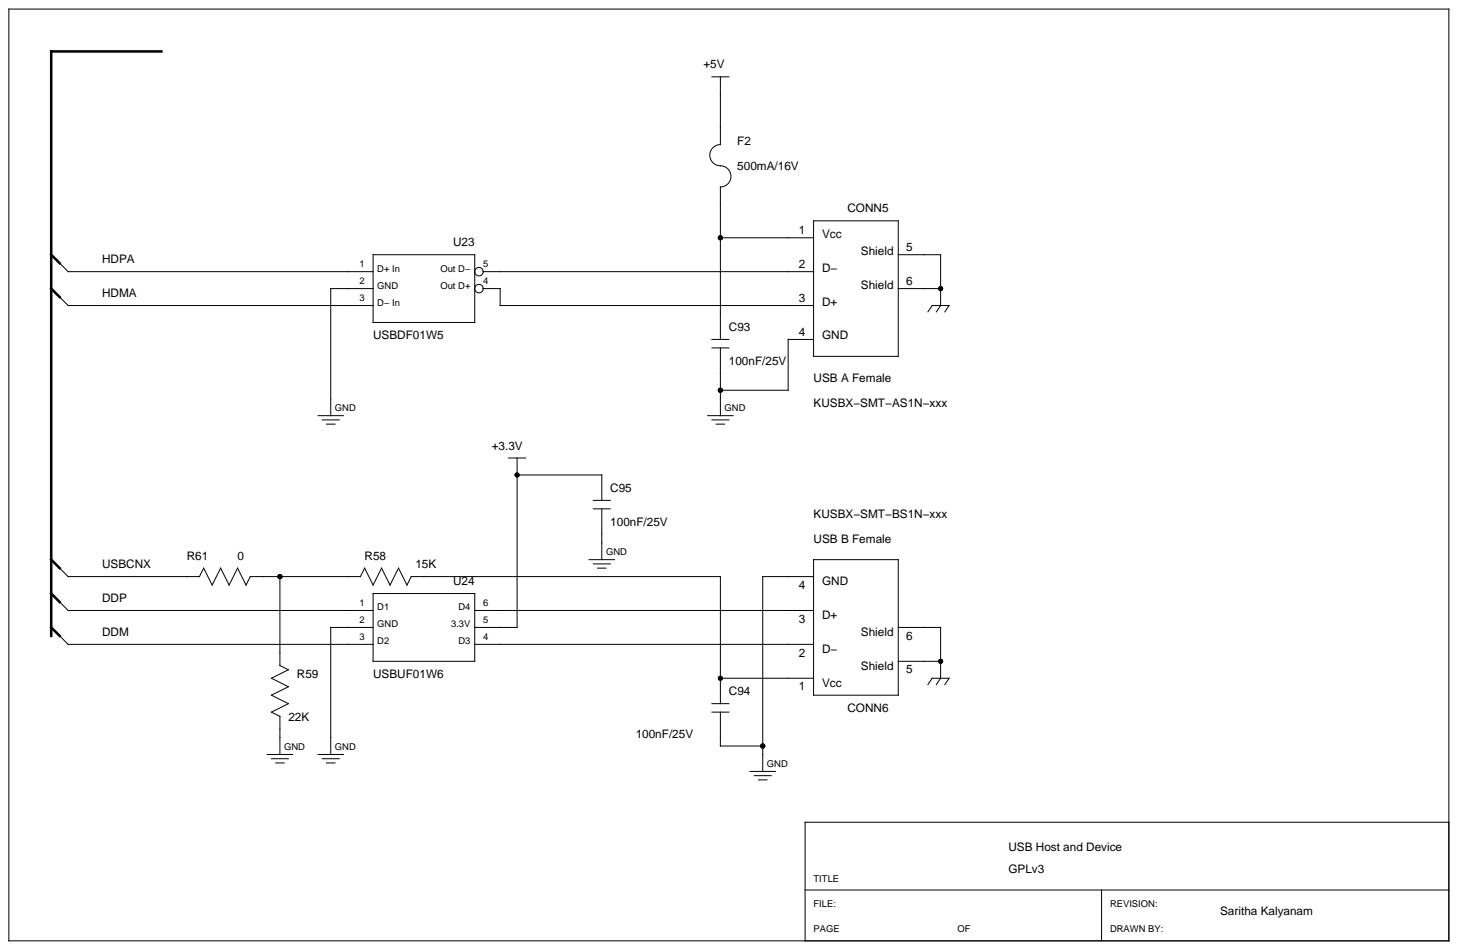
[picture p18: page 18]

USB Host and Device
GPLv3
