chipiki/gnu_friata/(commit log)

2008-05-22 Power considerations
2008-06-02 PQFP-208 footprint
2008-06-03 symbol/footprint fixes
    [AT91SAM9260.sch]
2008-06-12 LM3940 sym
    [LM3940.sch]
2008-06-12 LM3940 sym/pkg
    [GND.sch, LM3940.sch]
2008-06-12 schematic: power
    [LM3940.sch, power.sch]
2008-06-17 schematic: eth
    [2V5-plus.sch, KS8721BL.sch, friata-at91sam9260.sch, friata-eth.sch, friata-power.sch]
2008-07-20 schem cleanup
    [friata-cpu-2.sch, friata-cpu-3.sch, friata-eth.sch, friata-flash.sch, friata-mem-1.sch, friata-mem-2.sch, friata-mem.sch, friata-pwr.sch]
2008-07-31 pwr schem
    [friata-cpu-1.sch, friata-pwr-1.sch, friata-pwr-2.sch]
